zmolnar/sensorio/housing/sensorio.FCStd

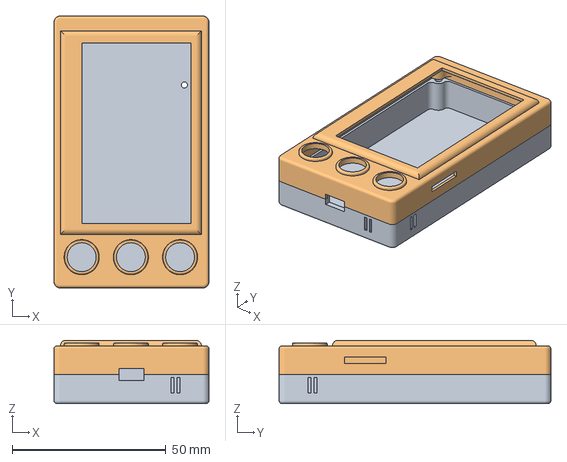
[picture p1: CAD file, 2021-02-22]
housing/sensorio.FCStd
50.4 x 88.4 x 20.6 mm
BackCover
sensorio_v0.4
