zmolnar/sensorio/housing/STL/v0.4/sensorio_v0.4.stl

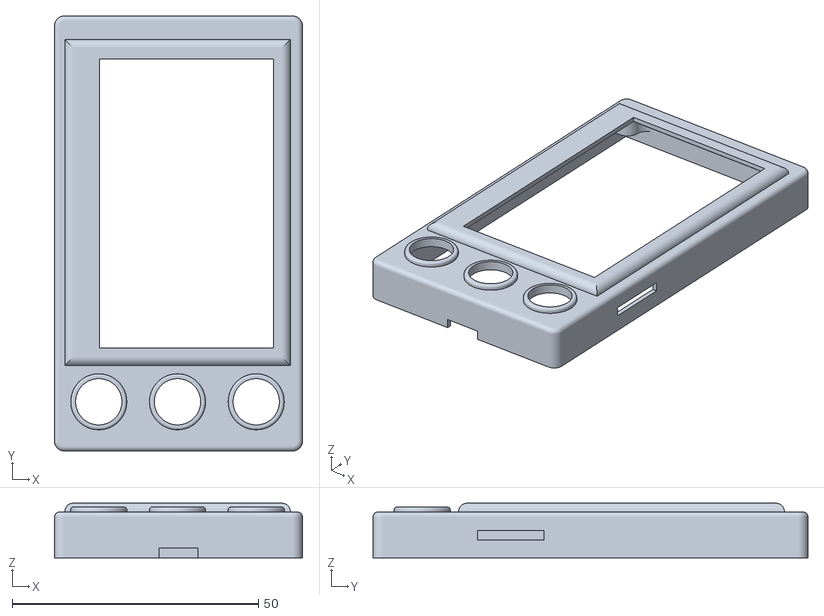
[picture p2: CAD file, 2021-02-16]
housing/STL/v0.4/sensorio_v0.4.stl
50.4 x 88.4 x 11.1
