zmolnar/sensorio/housing/STL/v0.1/button_v01.stl

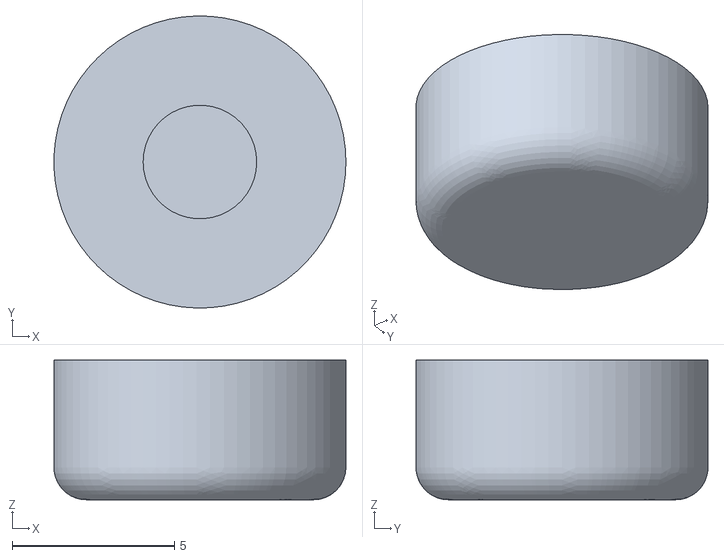
[picture p3: CAD file, 2021-01-31, an earlier design]
housing/STL/v0.1/button_v01.stl
9.00 x 9.00 x 4.30
