zmolnar/sensorio/housing/STL/v0.2/sensorio_v0.2.stl

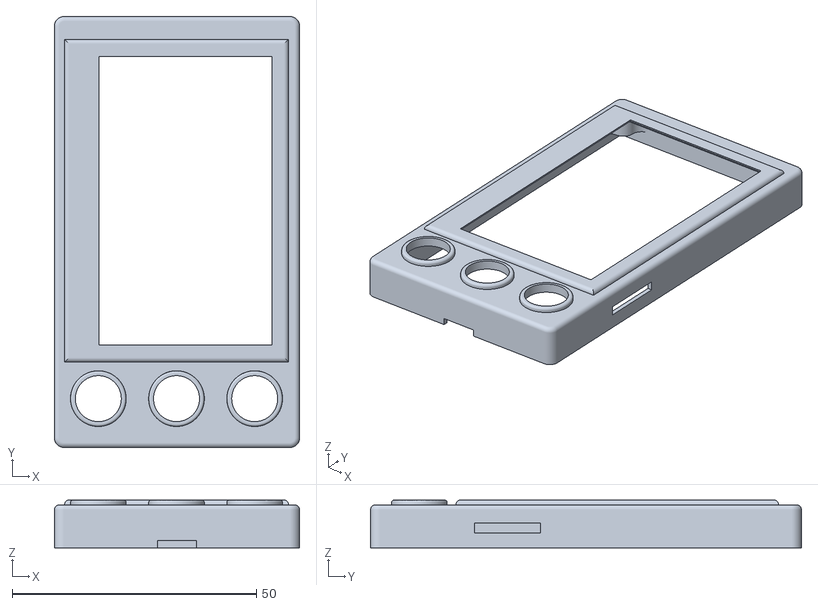
[picture p4: CAD file, 2021-02-11, an earlier design]
housing/STL/v0.2/sensorio_v0.2.stl
50.2 x 88.2 x 9.80
