zmolnar/sensorio/housing/STL/v0.3/sensorio_v0.3.stl

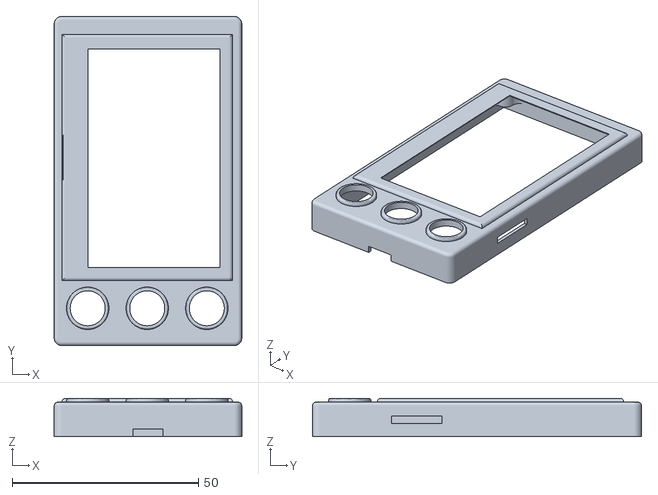
[picture p5: CAD file, 2021-02-11, an earlier design]
housing/STL/v0.3/sensorio_v0.3.stl
50.4 x 88.4 x 10.3
