zmolnar/sensorio/(list of files, cad)

Other CAD files:
housing/STL/v0.3/button_v0.3.stl
