zmolnar/sensorio/hardware/v1/v1.kicad_pcb

## KiCad design hardware/v1/v1.kicad_pcb (2020-12-09)

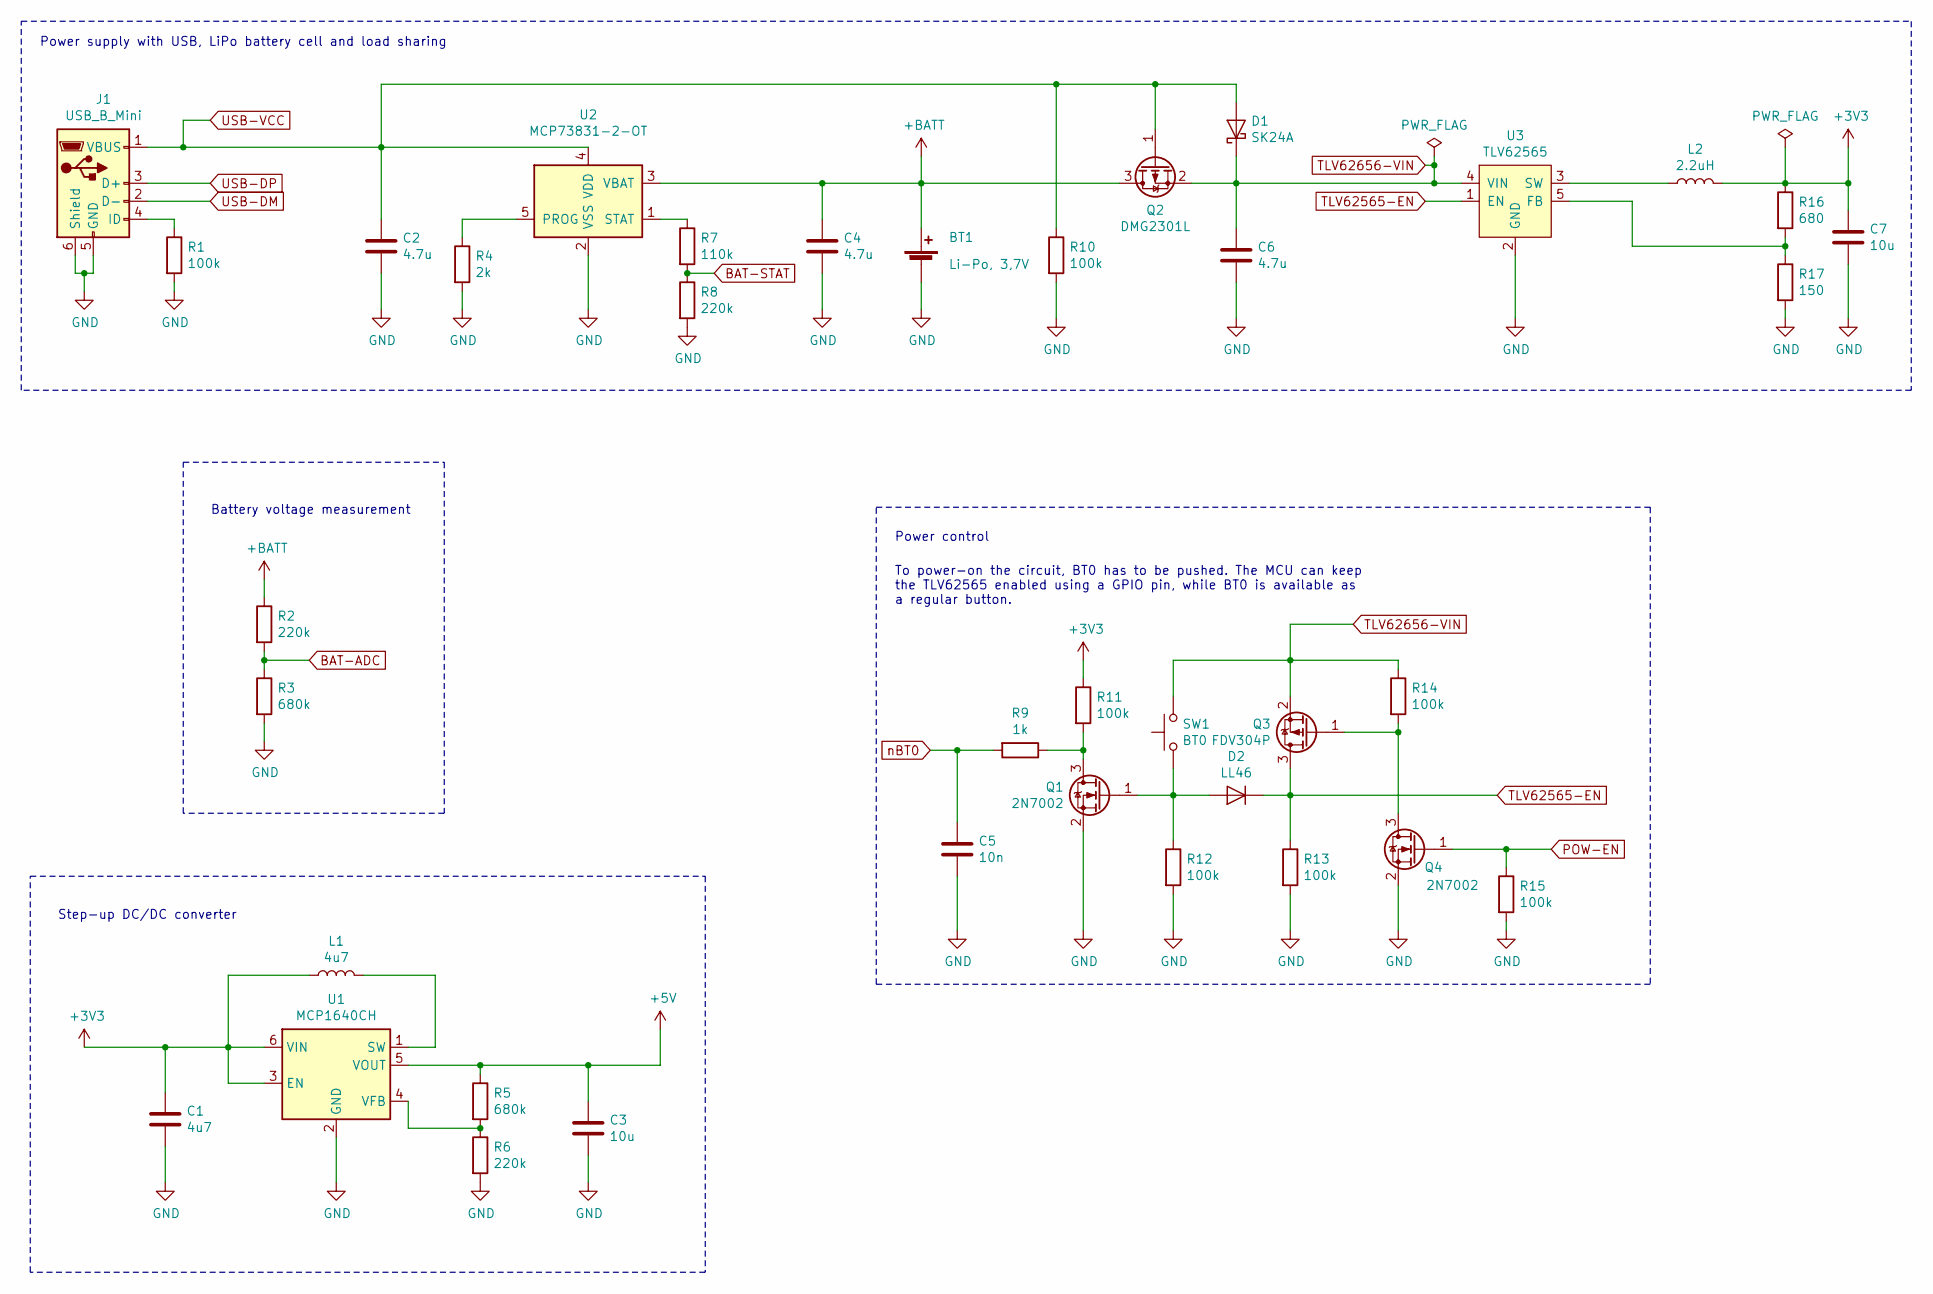
[picture p6: schematic Power.sch]

Parts:
BT1: Li-Po, 3,7V; Battery_103450
C1: 4u7; C_0603_1608Metric_Pad1.05x0.95mm_HandSolder
C2, C4, C6: 4.7u; C_0603_1608Metric_Pad1.05x0.95mm_HandSolder
C3, C7: 10u; C_0603_1608Metric_Pad1.05x0.95mm_HandSolder
C5: 10n; C_0603_1608Metric_Pad1.05x0.95mm_HandSolder
D1: SK24A; D_SMA_Handsoldering
D2: LL46; D_MiniMELF
J1: USB_B_Mini; USB_Mini-B_Lumberg_2486_01_Horizontal
L1: 4u7; Viking_Tech_SDIA0315
L2: 2.2uH; Murata_2u2H_LQH44PN2R2MP0L
Q1, Q4: 2N7002; SOT-23
Q2: DMG2301L; SOT-23; Farnell 3127313
Q3: FDV304P; SOT-23
R1, R10, R11, R12, R13, R14, R15: 100k; R_0603_1608Metric_Pad1.05x0.95mm_HandSolder
R2, R6, R8: 220k; R_0603_1608Metric_Pad1.05x0.95mm_HandSolder
R3, R5: 680k; R_0603_1608Metric_Pad1.05x0.95mm_HandSolder
R4: 2k; R_0603_1608Metric_Pad1.05x0.95mm_HandSolder
R7: 110k; R_0603_1608Metric_Pad1.05x0.95mm_HandSolder
R9: 1k; R_0603_1608Metric_Pad1.05x0.95mm_HandSolder
R16: 680; R_0603_1608Metric_Pad1.05x0.95mm_HandSolder
R17: 150; R_0603_1608Metric_Pad1.05x0.95mm_HandSolder
SW1: BT0; SW_SPST_PTS645
U1: MCP1640CH; SOT-23-6
U2: MCP73831-2-OT; SOT-23-5
U3: TLV62565; SOT-23-5_HandSoldering

Connections:
+3V3: C1.1, C7.1, L1.1, L2.2, R11.1, R16.1, U1.3 (EN), U1.6 (VIN); also elsewhere on the board
+5V: C3.1, R5.1, U1.5 (VOUT); also elsewhere on the board
+BATT: BT1.1 (+), C4.1, Q2.3 (D), R2.1, U2.3 (VBAT)
BAT-ADC: R2.2, R3.1; also elsewhere on the board
BAT-STAT: R7.2, R8.1; also elsewhere on the board
unnamed: D2.2 (A), Q1.1 (G), R12.1, SW1.1
unnamed: J1.4 (ID), R1.1
unnamed: L1.2, U1.1 (SW)
unnamed: L2.1, U3.3 (SW)
unnamed: Q1.3 (D), R9.1, R11.2
unnamed: Q3.1 (G), Q4.3 (D), R14.2
unnamed: R4.1, U2.5 (PROG)
unnamed: R5.2, R6.1, U1.4 (VFB)
unnamed: R7.1, U2.1 (STAT)
unnamed: R16.2, R17.1, U3.5 (FB)
POW-EN: Q4.1 (G), R15.1; also elsewhere on the board
TLV62565-EN: D2.1 (K), Q3.3 (D), R13.1, U3.1 (EN)
TLV62656-VIN: C6.1, D1.1 (K), Q2.2 (S), Q3.2 (S), R14.1, SW1.2, U3.4 (VIN)
USB-DM: J1.2 (D-); also elsewhere on the board
USB-DP: J1.3 (D+); also elsewhere on the board
USB-VCC: C2.1, D1.2 (A), J1.1 (VBUS), Q2.1 (G), R10.1, U2.4 (VDD); also elsewhere on the board
nBT0: C5.1, R9.2; also elsewhere on the board

Notes on the sheet:
To power-on the circuit, BT0 has to be pushed. The MCU can keep the TLV62565 enabled using a GPIO pin, while BT0 is available as a regular button.
Power supply with USB, LiPo battery cell and load sharing
Step-up DC/DC converter
Battery voltage measurement
Power control

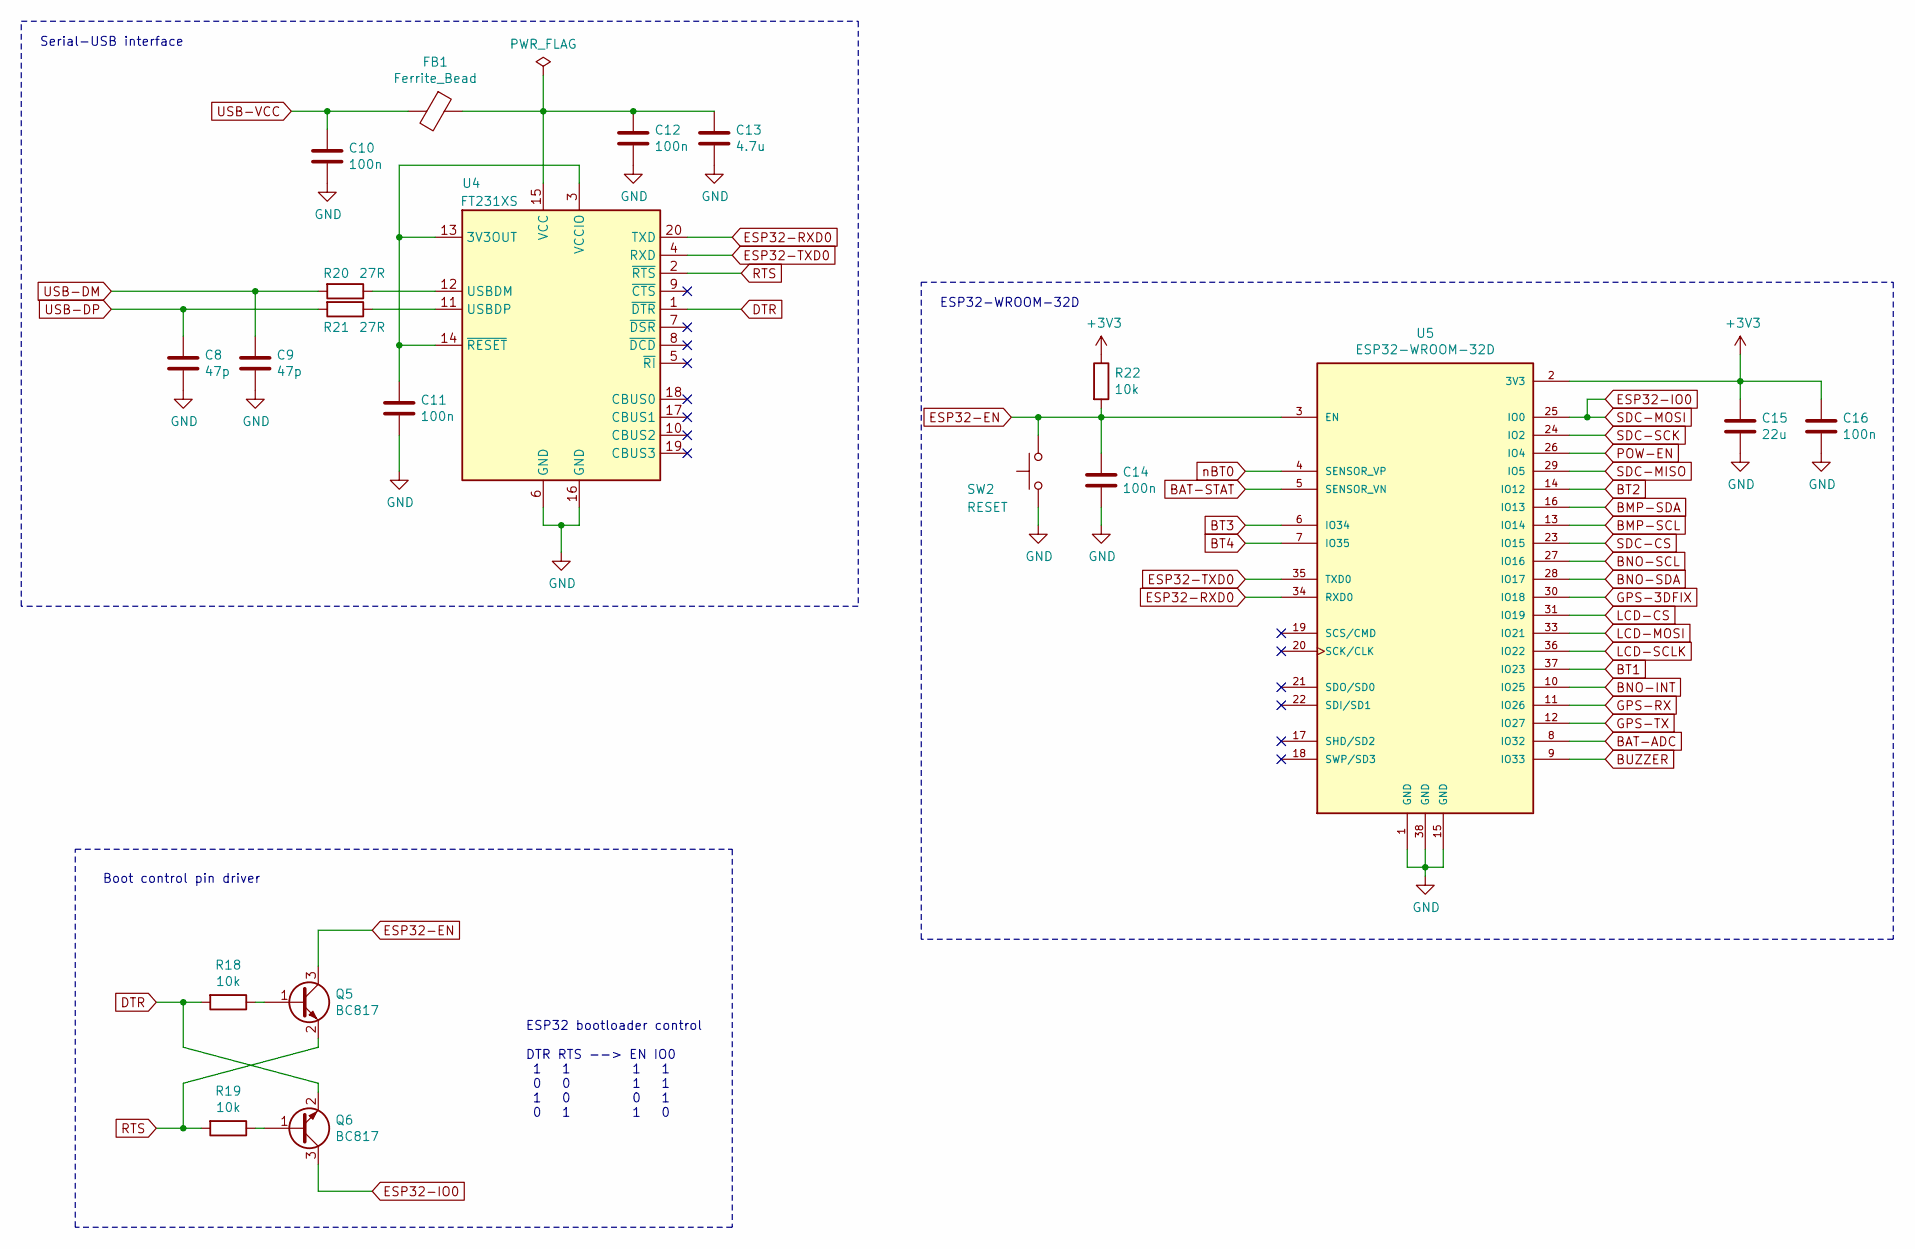
[picture p7: schematic ESP32.sch]

Parts:
C8, C9: 47p; C_0603_1608Metric_Pad1.05x0.95mm_HandSolder
C10, C11, C12, C14, C16: 100n; C_0603_1608Metric_Pad1.05x0.95mm_HandSolder
C13: 4.7u; C_0603_1608Metric_Pad1.05x0.95mm_HandSolder
C15: 22u; C_0603_1608Metric_Pad1.05x0.95mm_HandSolder
FB1: Ferrite_Bead; L_0603_1608Metric_Pad1.05x0.95mm_HandSolder
Q5, Q6: BC817; SOT-23
R18, R19, R22: 10k; R_0603_1608Metric_Pad1.05x0.95mm_HandSolder
R20, R21: 27R; R_0603_1608Metric_Pad1.05x0.95mm_HandSolder
SW2: RESET; SW_SPST_PTS645
U4: FT231XS; SSOP-20_3.9x8.7mm_P0.635mm
U5: ESP32-WROOM-32D; PARTREV 1.9

Connections:
+3V3: C15.1, C16.1, R22.1, U5.2 (3V3); also elsewhere on the board
BAT-ADC: U5.8 (IO32); also elsewhere on the board
BAT-STAT: U5.5 (SENSOR_VN); also elsewhere on the board
BMP-SCL: U5.13 (IO14); also elsewhere on the board
BMP-SDA: U5.16 (IO13); also elsewhere on the board
BNO-INT: U5.10 (IO25); also elsewhere on the board
BNO-SCL: U5.27 (IO16); also elsewhere on the board
BNO-SDA: U5.28 (IO17); also elsewhere on the board
BT1: U5.37 (IO23); also elsewhere on the board
BT2: U5.14 (IO12); also elsewhere on the board
BT3: U5.6 (IO34); also elsewhere on the board
BT4: U5.7 (IO35); also elsewhere on the board
BUZZER: U5.9 (IO33); also elsewhere on the board
DTR: Q6.2 (E), R18.2, U4.1 (~DTR)
ESP32-EN: C14.1, Q5.3 (C), R22.2, SW2.2, U5.3 (EN)
ESP32-IO0: Q6.3 (C), U5.25 (IO0); also elsewhere on the board
ESP32-RXD0: U4.20 (TXD), U5.34 (RXD0)
ESP32-TXD0: U4.4 (RXD), U5.35 (TXD0)
GPS-3DFIX: U5.30 (IO18); also elsewhere on the board
GPS-RX: U5.11 (IO26); also elsewhere on the board
GPS-TX: U5.12 (IO27); also elsewhere on the board
LCD-CS: U5.31 (IO19); also elsewhere on the board
LCD-MOSI: U5.33 (IO21); also elsewhere on the board
LCD-SCLK: U5.36 (IO22); also elsewhere on the board
unnamed: C11.1, U4.3 (VCCIO), U4.13 (3V3OUT), U4.14 (~RESET)
unnamed: C12.1, C13.1, FB1.1, U4.15 (VCC)
unnamed: Q5.1 (B), R18.1
unnamed: Q6.1 (B), R19.1
unnamed: R20.1, U4.12 (USBDM)
unnamed: R21.1, U4.11 (USBDP)
POW-EN: U5.26 (IO4); also elsewhere on the board
RTS: Q5.2 (E), R19.2, U4.2 (~RTS)
SDC-CS: U5.23 (IO15); also elsewhere on the board
SDC-MISO: U5.29 (IO5); also elsewhere on the board
SDC-SCK: U5.24 (IO2); also elsewhere on the board
USB-DM: C9.1, R20.2; also elsewhere on the board
USB-DP: C8.1, R21.2; also elsewhere on the board
USB-VCC: C10.1, FB1.2; also elsewhere on the board
nBT0: U5.4 (SENSOR_VP); also elsewhere on the board

Notes on the sheet:
ESP32 bootloader control DTR RTS --> EN IO0 1 1 1 1 0 0 1 1 1 0 0 1 0 1 1 0
Serial-USB interface
Boot control pin driver
ESP32-WROOM-32D

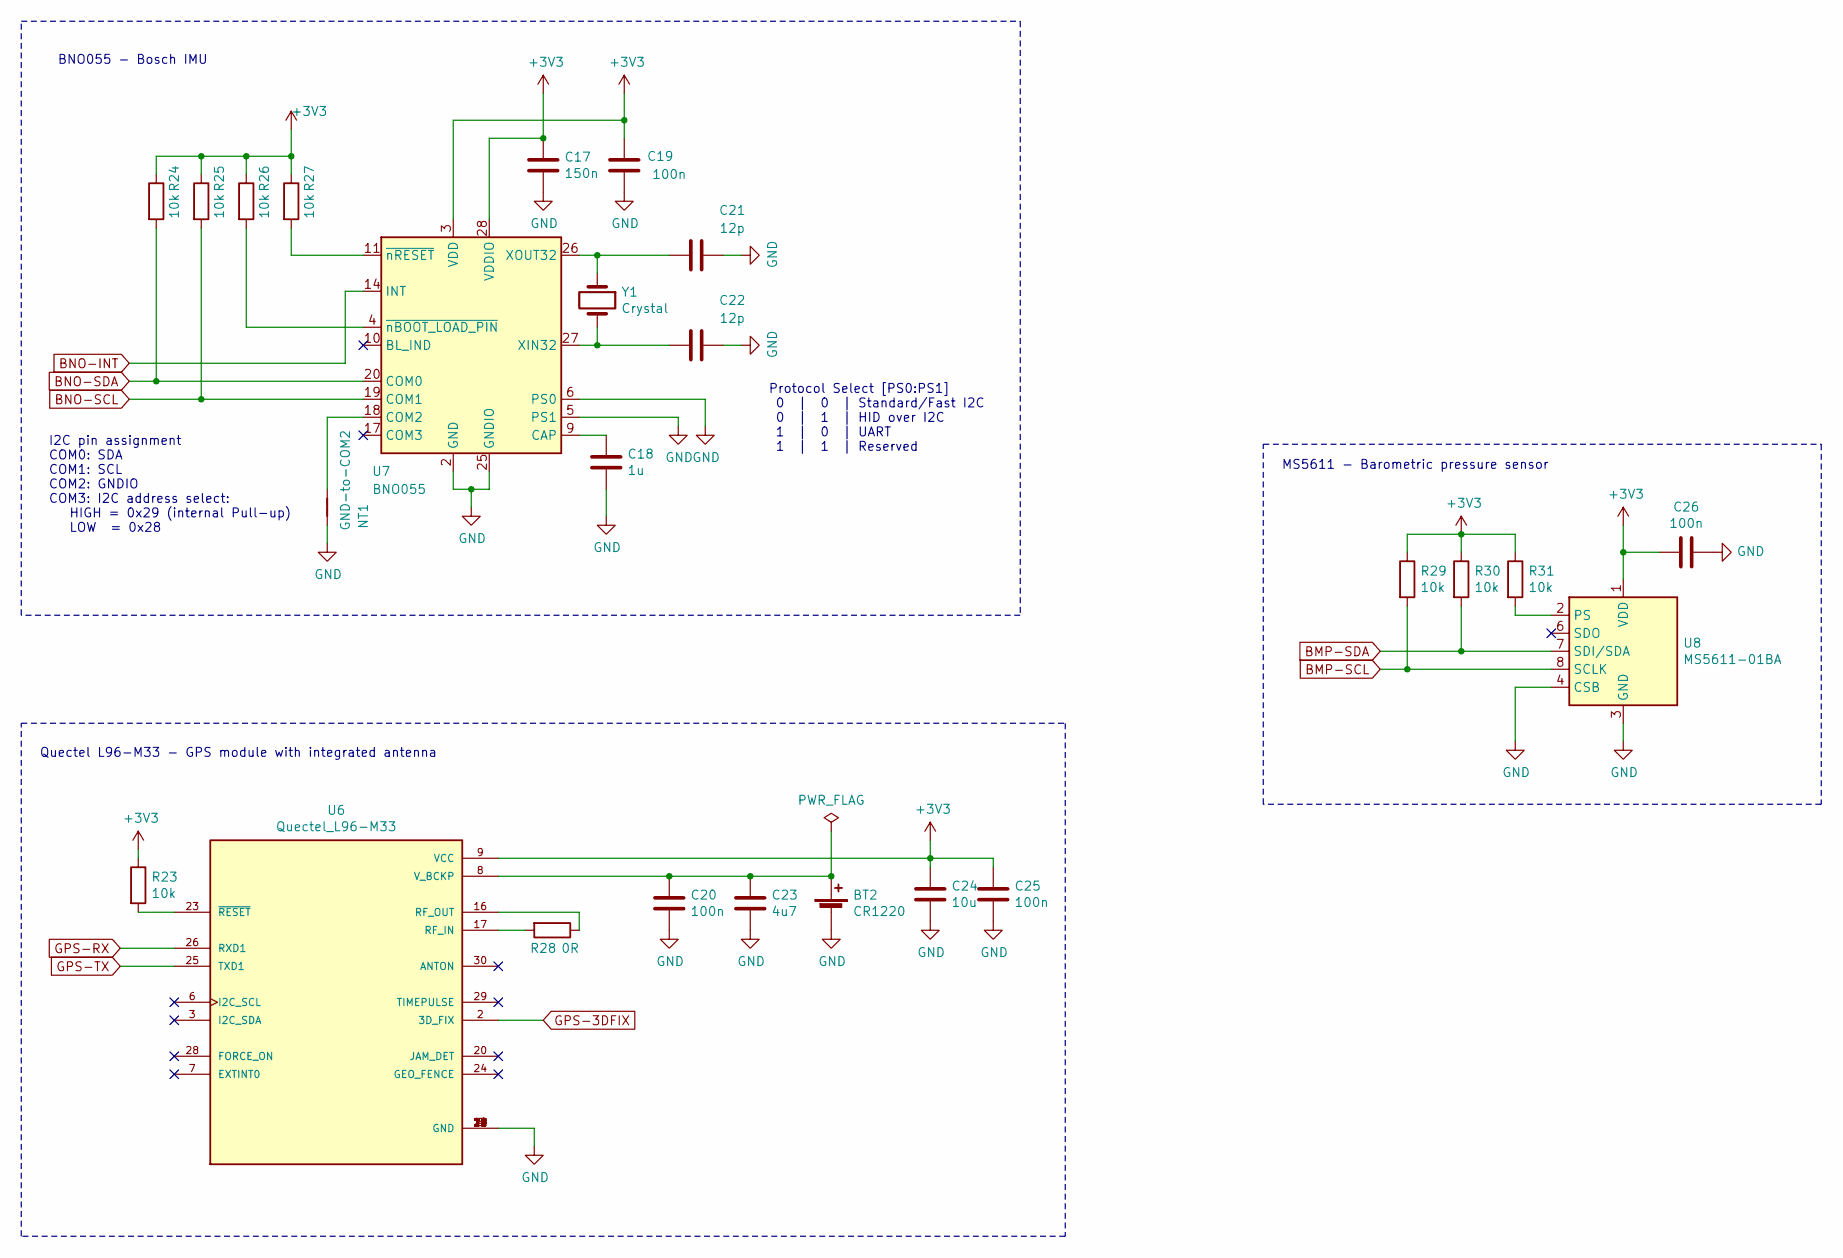
[picture p8: schematic Sensors.sch]

Parts:
BT2: CR1220; BatteryHolder_Keystone_3001_1x12mm; Mouser 534-3001
C17: 150n; C_0603_1608Metric_Pad1.05x0.95mm_HandSolder
C18: 1u; C_0603_1608Metric_Pad1.05x0.95mm_HandSolder
C19, C20, C25, C26: 100n; C_0603_1608Metric_Pad1.05x0.95mm_HandSolder
C21, C22: 12p; C_0603_1608Metric_Pad1.05x0.95mm_HandSolder
C23: 4u7; C_0603_1608Metric_Pad1.05x0.95mm_HandSolder
C24: 10u; C_0603_1608Metric_Pad1.05x0.95mm_HandSolder
NT1: GND-to-COM2; NetTie-2_SMD_Pad0.5mm
R23, R24, R25, R26, R27, R29, R30, R31: 10k; R_0603_1608Metric_Pad1.05x0.95mm_HandSolder
R28: 0R; R_0603_1608Metric_Pad1.05x0.95mm_HandSolder
U6: Quectel_L96-M33
U7: BNO055; LGA-28_5.2x3.8mm_P0.5mm
U8: MS5611-01BA; LGA-8_3x5mm_P1.25mm
Y1: Crystal; Abracon_ABS07-32.768KHZ-T

Connections:
+3V3: C17.2, C19.2, C24.1, C25.1, C26.2, R23.1, R24.1, R25.1, R26.1, R27.1, R29.1, R30.1, R31.1, U6.9 (VCC), U7.3 (VDD), U7.28 (VDDIO), U8.1 (VDD); also elsewhere on the board
BMP-SCL: R29.2, U8.8 (SCLK); also elsewhere on the board
BMP-SDA: R30.2, U8.7 (SDI/SDA); also elsewhere on the board
BNO-INT: U7.14 (INT); also elsewhere on the board
BNO-SCL: R25.2, U7.19 (COM1); also elsewhere on the board
BNO-SDA: R24.2, U7.20 (COM0); also elsewhere on the board
GPS-3DFIX: U6.2 (3D_FIX); also elsewhere on the board
GPS-RX: U6.26 (RXD1); also elsewhere on the board
GPS-TX: U6.25 (TXD1); also elsewhere on the board
unnamed: BT2.1 (+), C20.1, C23.1, U6.8 (V_BCKP)
unnamed: C18.1, U7.9 (CAP)
unnamed: C21.2, U7.26 (XOUT32), Y1.1
unnamed: C22.2, U7.27 (XIN32), Y1.2
unnamed: NT1.1, U7.18 (COM2)
unnamed: R23.2, U6.23 (~RESET)
unnamed: R26.2, U7.4 (~nBOOT_LOAD_PIN)
unnamed: R27.2, U7.11 (~nRESET)
unnamed: R28.1, U6.16 (RF_OUT)
unnamed: R28.2, U6.17 (RF_IN)
unnamed: R31.2, U8.2 (PS)

Notes on the sheet:
I2C pin assignment COM0: SDA COM1: SCL COM2: GNDIO COM3: I2C address select: HIGH = 0x29 (internal Pull-up) LOW = 0x28
Protocol Select [PS0:PS1] 0 | 0 | Standard/Fast I2C 0 | 1 | HID over I2C 1 | 0 | UART 1 | 1 | Reserved
BNO055 - Bosch IMU
MS5611 - Barometric pressure sensor
Quectel L96-M33 - GPS module with integrated antenna

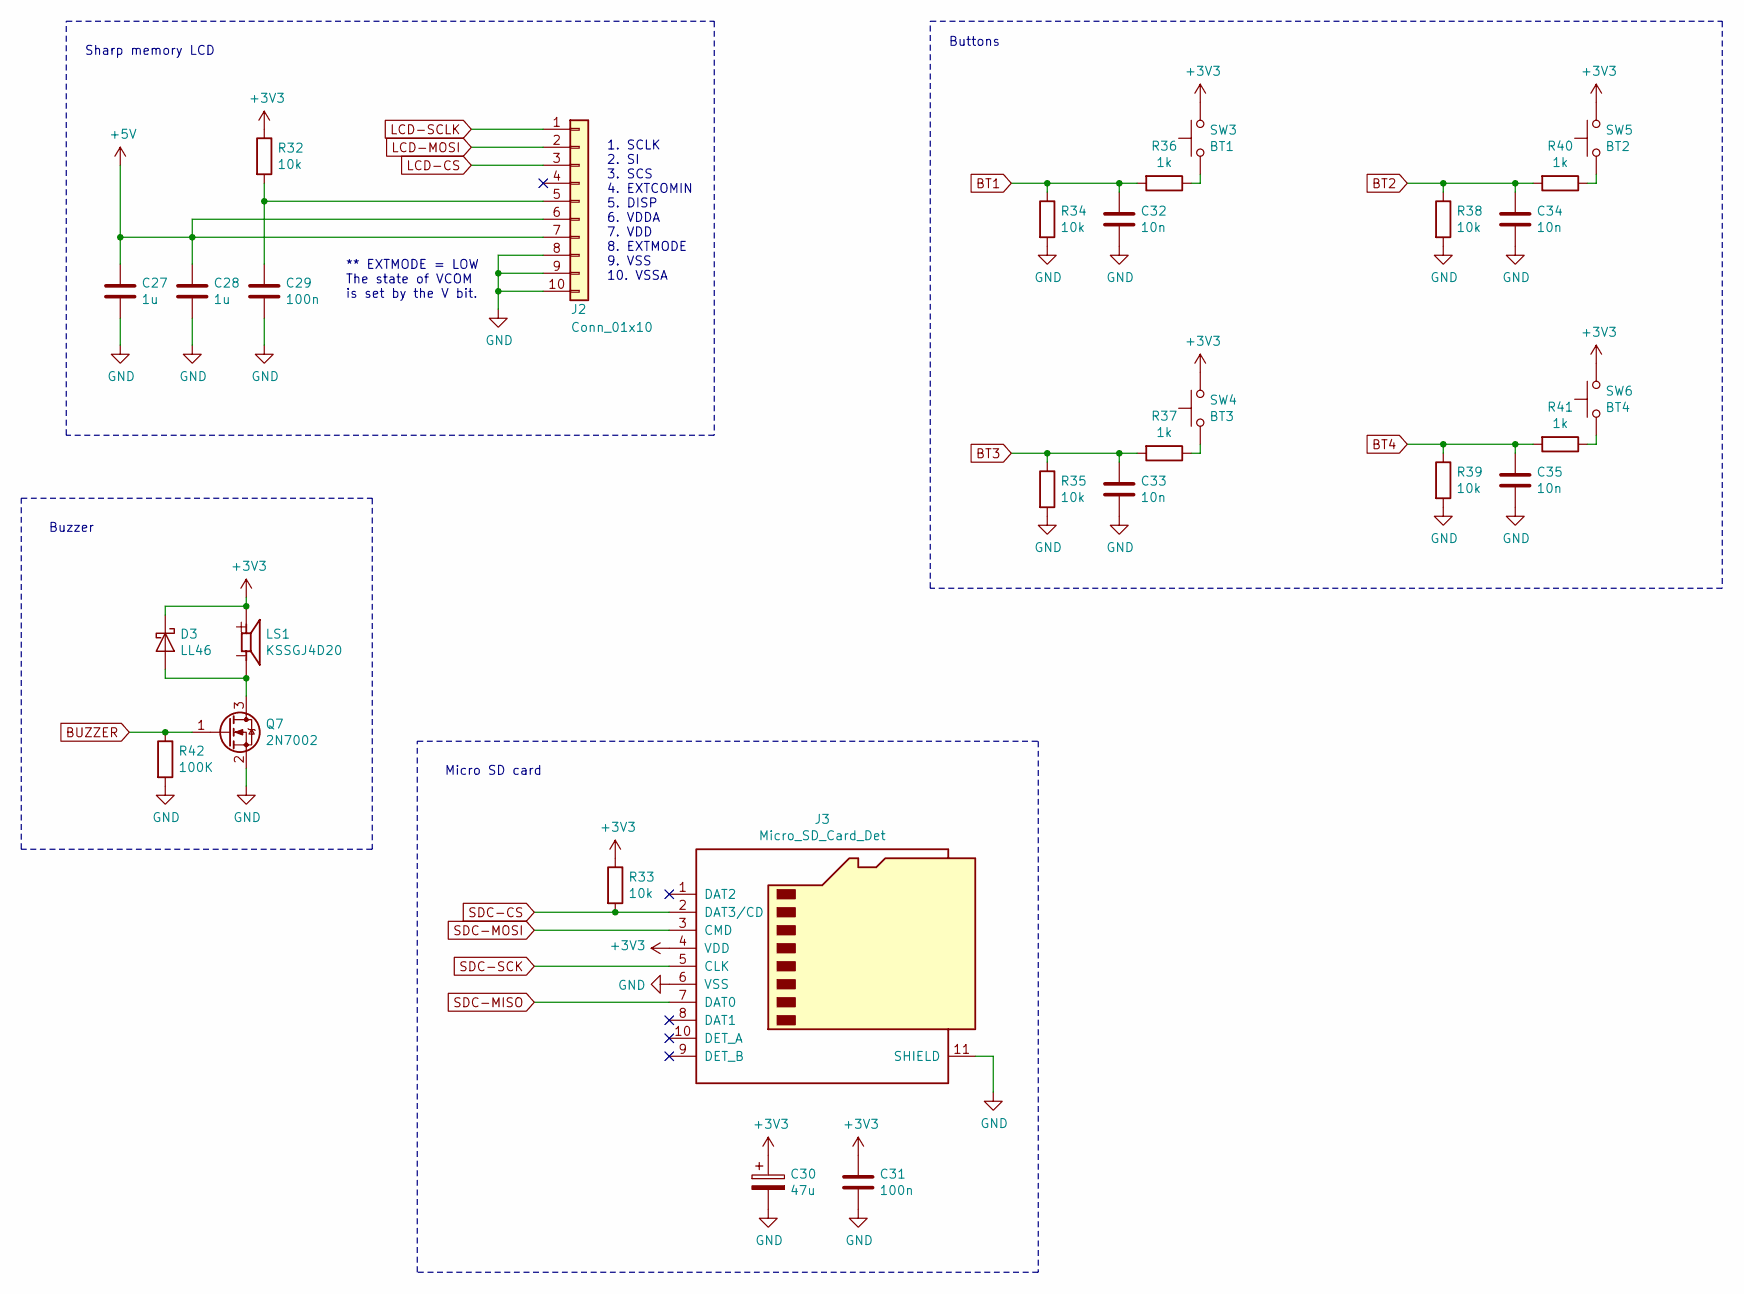
[picture p9: schematic Peripherals.sch]

Parts:
C27, C28: 1u; C_0603_1608Metric_Pad1.05x0.95mm_HandSolder
C29, C31: 100n; C_0603_1608Metric_Pad1.05x0.95mm_HandSolder
C30: 47u; CP_EIA-3528-21_Kemet-B_Pad1.50x2.35mm_HandSolder
C32, C33, C34, C35: 10n; C_0603_1608Metric_Pad1.05x0.95mm_HandSolder
D3: LL46; D_MiniMELF
J2: Conn_01x10; Wuerth_10pin_FPC_68711014022; Farnell top 1641925
J3: Micro_SD_Card_Det; microSD_HC_Hirose_DM3AT-SF-PEJM5
LS1: KSSGJ4D20; PARTREV 1.5
Q7: 2N7002; SOT-23
R32, R33, R34, R35, R38, R39: 10k; R_0603_1608Metric_Pad1.05x0.95mm_HandSolder
R36, R37, R40, R41: 1k; R_0603_1608Metric_Pad1.05x0.95mm_HandSolder
R42: 100K; R_0603_1608Metric_Pad1.05x0.95mm_HandSolder
SW3: BT1; SW_SPST_PTS645
SW4: BT3; Connector_SMD_01x02_2.54
SW5: BT2; SW_SPST_PTS645
SW6: BT4; Connector_SMD_01x02_2.54

Connections:
+3V3: C30.1, C31.1, D3.1 (K), J3.4 (VDD), LS1.P1, LS1.P2, R32.1, R33.1, SW3.2, SW4.2, SW5.2, SW6.2; also elsewhere on the board
+5V: C27.1, C28.1, J2.6, J2.7; also elsewhere on the board
BT1: C32.1, R34.1, R36.2; also elsewhere on the board
BT2: C34.1, R38.1, R40.2; also elsewhere on the board
BT3: C33.1, R35.1, R37.2; also elsewhere on the board
BT4: C35.1, R39.1, R41.2; also elsewhere on the board
BUZZER: Q7.1 (G), R42.1; also elsewhere on the board
ESP32-IO0: J3.3 (CMD); also elsewhere on the board
LCD-CS: J2.3; also elsewhere on the board
LCD-MOSI: J2.2; also elsewhere on the board
LCD-SCLK: J2.1; also elsewhere on the board
unnamed: C29.1, J2.5, R32.2
unnamed: D3.2 (A), LS1.N1, LS1.N2, Q7.3 (D)
unnamed: R36.1, SW3.1
unnamed: R37.1, SW4.1
unnamed: R40.1, SW5.1
unnamed: R41.1, SW6.1
SDC-CS: J3.2 (DAT3/CD), R33.2; also elsewhere on the board
SDC-MISO: J3.7 (DAT0); also elsewhere on the board
SDC-SCK: J3.5 (CLK); also elsewhere on the board

Notes on the sheet:
** EXTMODE = LOW The state of VCOM is set by the V bit.
1. SCLK 2. SI 3. SCS 4. EXTCOMIN 5. DISP 6. VDDA 7. VDD 8. EXTMODE 9. VSS 10. VSSA
Sharp memory LCD
Buzzer
Micro SD card
Buttons

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
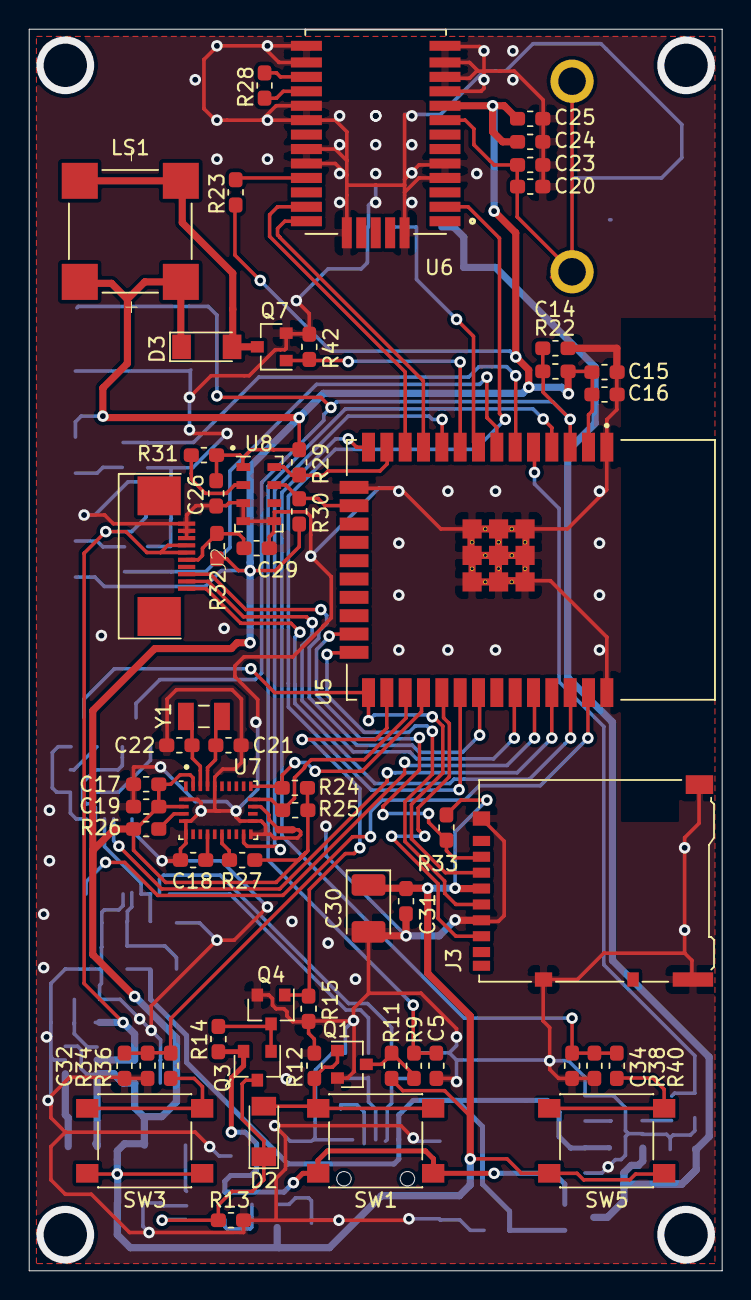
[picture p10: board v1.kicad_pcb from above]

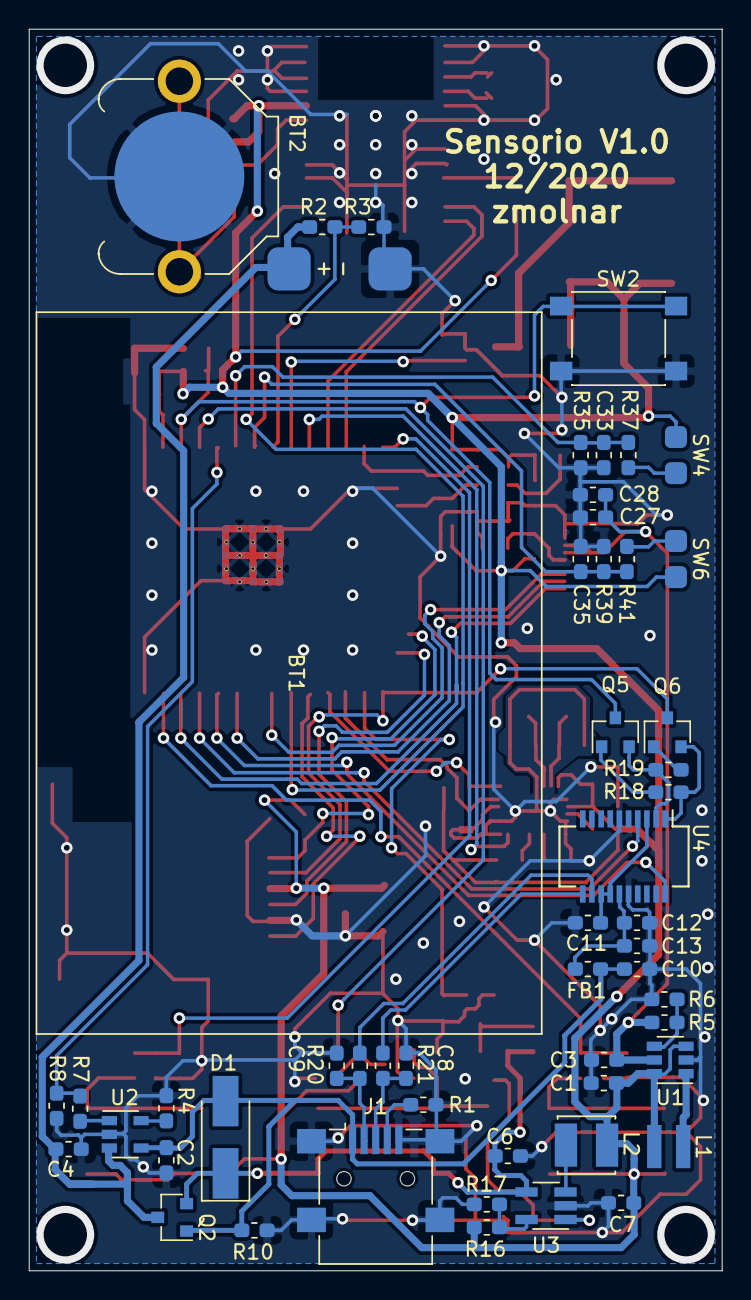
[picture p11: board v1.kicad_pcb from below]

Board: 2 copper layers, 48.0 x 86.0 mm, 112 parts (52 on the bottom side), 71 nets.
