zmolnar/sensorio/firmware/sensorio/src/main.cpp

//
//  This file is part of Sensorio.
//
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

#include <Power.hpp>
#include <core/BatteryMonitorThread.hpp>
#include <core/BeepControlThread.hpp>
#include <core/DataFilterThread.hpp>
#include <core/DataLoggerThread.hpp>
#include <core/GpsManagerThread.hpp>
#include <core/ImuManagerThread.hpp>
#include <core/LvglThread.hpp>
#include <core/PressureReaderThread.hpp>
#include <dashboard/Config.hpp>
#include <dashboard/Dashboard.hpp>
#include <dashboard/NvsStorage.hpp>
#include <dashboard/RawSerializer.hpp>
#include <platform/Log.hpp>

#include <freertos/FreeRTOS.h>
#include <freertos/task.h>

typedef enum {
  PRIO_0_INVALID = 0,
  PRIO_0_BATTMON,
  PRIO_0_LOGGER,
  PRIO_0_BEEPER,
  PRIO_0_GPS,
  PRIO_0_FILTER,
  PRIO_0_IMU,
  PRIO_0_PRESS,
} ThreadPrio_Core0_t;

typedef enum {
  PRIO_1_INVALID = 0,
  PRIO_1_LVGL = 10,
} ThreadPrio_Core1_t;

static const char *tag = "MAIN";

Power Power::obj{};
Dashboard::Dashboard dashboard{};
Config::RawSerializer serializer{};
Config::NvsStorage storage{};
Config::Config config{serializer, storage};

using namespace Platform;

extern "C" void app_main(void) {
  Log::Base::setLevel(Log::Level::DEBUG);
  Log::Info(tag) << "Sensorio started";

  Power::get().start();

  PressureReaderThreadInit();
  ImuManagerThreadInit();
  GpsManagerThreadInit();
  DataFilterThreadInit();
  DataLoggerThreadInit();
  BeepControlThreadInit();
  BatteryMonitorInit();

  storage.init();
  config.load();

#if 1
  xTaskCreatePinnedToCore(
      DataFilterThread, "data filter", 8192, NULL, PRIO_0_FILTER, NULL, 0);
#endif

#if 1
  xTaskCreatePinnedToCore(
      DataLoggerThread, "data logger", 8192, NULL, PRIO_0_LOGGER, NULL, 0);
#endif

#if 1
  xTaskCreatePinnedToCore(PressureReaderThread,
                          "pressure reader",
                          4096,
                          NULL,
                          PRIO_0_PRESS,
                          NULL,
                          0);
#endif

#if 1
  xTaskCreatePinnedToCore(
      BeepControlThread, "beeper", 4096, NULL, PRIO_0_BEEPER, NULL, 0);
#endif

#if 1
  xTaskCreatePinnedToCore(
      ImuManagerThread, "IMU manager", 4096, NULL, PRIO_0_IMU, NULL, 0);
#endif

#if 1
  xTaskCreatePinnedToCore(
      GpsManagerThread, "GPS thread", 4096, NULL, PRIO_0_GPS, NULL, 0);
#endif

#if 1
  xTaskCreatePinnedToCore(BatteryMonitorThread,
                          "Battery thread",
                          2048,
                          NULL,
                          PRIO_0_BATTMON,
                          NULL,
                          0);
#endif

#if 1
  xTaskCreatePinnedToCore(
      LvglThread, "LVGL thread", 16384, NULL, PRIO_1_LVGL, NULL, 1);
#endif

  while (1) {
    vTaskDelay(10000 / portTICK_RATE_MS);
  }
}
