zmolnar/sensorio/firmware/sensorio/src/gui/Sensorio.cpp

/**
 * @file Sensorio.c
 * @brief
 */

/*****************************************************************************/
/* INCLUDES                                                                  */
/*****************************************************************************/
#include "Sensorio.h"
#include "Power.hpp"
#include "core/DataLoggerThread.hpp"
// #include "dashboard/Dashboard.hpp"


#if defined(SIMULATOR)
#include <stdio.h>
#else
#include "core/LvglThread.hpp"
#endif

#include "screens/BpsData.h"
#include "screens/GpsData.h"
#include "screens/ImuData.h"
#include "screens/Startup.h"
#include "screens/SystemStatus.h"
#include "screens/Variometer.h"

/*****************************************************************************/
/* DEFINED CONSTANTS                                                         */
/*****************************************************************************/

/*****************************************************************************/
/* TYPE DEFINITIONS                                                          */
/*****************************************************************************/

/*****************************************************************************/
/* MACRO DEFINITIONS                                                         */
/*****************************************************************************/

/*****************************************************************************/
/* DEFINITION OF GLOBAL CONSTANTS AND VARIABLES                              */
/*****************************************************************************/
#if defined(SIMULATOR)
// Publish it to the global namespace, because app_hal.c needs it.
lv_group_t *encgroup;
#else
static lv_group_t *encgroup;
#endif

// Screen objects
lv_obj_t *startup;
lv_obj_t *vario;
lv_obj_t *bpsdata;
lv_obj_t *imudata;
lv_obj_t *gpsdata;
lv_obj_t *sysstat;

// Default style for the screens
static lv_style_t no_border_style;

// Exit confirmation message box button labels
static const char *exitMsgButtons[] = {"Yes", "Cancel", ""};

/*****************************************************************************/
/* DECLARATION OF LOCAL FUNCTIONS                                            */
/*****************************************************************************/

/*****************************************************************************/
/* DEFINITION OF LOCAL FUNCTIONS                                             */
/*****************************************************************************/
static void group_focus_cb(lv_group_t *g)
{
  lv_obj_t *obj = lv_group_get_focused(g);

  if (vario == obj) {
    lv_scr_load(vario);
  } else if (bpsdata == obj) {
    lv_scr_load(bpsdata);
  } else if (imudata == obj) {
    lv_scr_load(imudata);
  } else if (gpsdata == obj) {
    lv_scr_load(gpsdata);
  } else if (sysstat == obj) {
    lv_scr_load(sysstat);
  } else {
    ;
  }
}

static void exit_msgbox_event_handler(lv_obj_t *obj, lv_event_t event)
{
  if (LV_EVENT_VALUE_CHANGED == event) {
    uint16_t id = lv_msgbox_get_active_btn(obj);

    if (0 == id) {
      lv_obj_clean(lv_scr_act());
      SensorioStop();
    } else {
      SensorioLoadEncoderGroup();
      lv_group_focus_obj(lv_obj_get_parent(obj));
    }

    lv_obj_del(obj);
  }
}

/*****************************************************************************/
/* DEFINITION OF GLOBAL FUNCTIONS                                            */
/*****************************************************************************/
void SensorioStart(void)
{
  lv_style_init(&no_border_style);
  lv_style_set_border_width(&no_border_style, LV_STATE_DEFAULT, 0);

  startup = startup_screen_create(&no_border_style);

#if defined(SIMULATOR)
  // In the simulator app_hal.c will create the group.
#else
  encgroup = lv_group_create();
#endif

  lv_group_set_focus_cb(encgroup, group_focus_cb);

  lv_scr_load(startup);
}

void SensorioStop(void)
{
  LogWaitToFinish();
  Power::get().stop();
}

void SensorioStartupFinished(void)
{
  lv_obj_del(startup);

  vario = variometer_screen_create(&no_border_style);
  bpsdata = bps_data_screen_create(&no_border_style);
  imudata = imu_data_screen_create(&no_border_style);
  gpsdata = gps_data_screen_create(&no_border_style);
  sysstat = system_status_screen_create(&no_border_style);

  SensorioLoadEncoderGroup();
  lv_group_focus_obj(vario);

  Power::get().startupFinished();
}

lv_group_t *SensorioGetEncoderGroup(void)
{
  return encgroup;
}

void SensorioClearEncoderGroup(void)
{
  lv_group_remove_all_objs(encgroup);
  lv_group_set_editing(encgroup, false);
}

void SensorioLoadEncoderGroup(void)
{
  SensorioClearEncoderGroup();
  lv_group_add_obj(encgroup, vario);
  lv_group_add_obj(encgroup, bpsdata);
  lv_group_add_obj(encgroup, imudata);
  lv_group_add_obj(encgroup, gpsdata);
  lv_group_add_obj(encgroup, sysstat);
}

void SensorioConfirmExit(void)
{
  lv_obj_t *mbox = lv_msgbox_create(lv_scr_act(), NULL);
  lv_msgbox_set_text(mbox, "Do you want to exit?");
  lv_msgbox_add_btns(mbox, exitMsgButtons);
  lv_obj_set_width(mbox, 200);
  lv_obj_set_event_cb(mbox, exit_msgbox_event_handler);
  lv_obj_align(mbox, lv_scr_act(), LV_ALIGN_CENTER, 0, 0);

  lv_group_remove_all_objs(encgroup);
  lv_group_add_obj(encgroup, mbox);
}

/****************************** END OF FILE **********************************/
