zmolnar/sensorio/(commit log)

2020-06-02 Copy files from stm32f103-stk EPD prototyping.
2020-07-12 Update board config files and add template for ChibiStudio.
2020-07-17 Create LED blinker and configure SWO pin.
2020-07-18 Add sampler thread ans LPS22HB sensor to the project.
2020-07-19 Add LPS22HB DRDY interrupt handling.
2020-07-19 Remove ChibiOS submodule and add its content as source files.
    [STM32L4+.ods, stm_spc56ec74a256s_spc56ec74_minimodule_debug_jtag.cfg, stm_xpc560b64_minimodule_debug_jtag.cfg, stm_xpc560b_spc560d40_minimodule_debug_jtag.cfg, stm_xpc560p_minimodule_40mhz_debug_jtag.cfg, stm_xpc563m64_minimodule_debug_jtag.cfg, stm_xpc564a_spc564a70_minimodule_debug_jtag.cfg, stm_xpc56el_minimodule_lockstep_debug_jtag.cfg]
2020-09-19 Add SWO printout to debug data.
2020-10-14 Make UART work to transmit data. Setup LSM6DSL sensor.
2020-12-06 Board V1.0 all nets connected.
    [ESP32.sch, Peripherals.sch, Power.sch, Proto.sch, Sensors.sch, v1.kicad_pcb, v1.sch]
2020-12-06 Tracks sorted out, without ground plane.
    [v1.kicad_pcb]
2020-12-07 V1.0 RC1
    [v1.kicad_pcb]
2020-12-08 V1.0 RC2
    [v1.csv, v1.kicad_pcb, v1_bom.xlsx]
2020-12-09 V1.0 RC3
    [v1.kicad_pcb, v1_bom.xlsx]
2020-12-09 V1.0 final revision
    [v1-B_Cu.gbl, v1-B_Mask.gbs, v1-B_SilkS.gbo, v1-F_Cu.gtl, v1-F_Mask.gts, v1-F_SilkS.gto, v1-NPTH.drl, v1-PTH.drl]
2020-12-24 Remove all files from firmware folder.
    [STM32L4+.ods, stm_spc56ec74a256s_spc56ec74_minimodule_debug_jtag.cfg, stm_xpc560b64_minimodule_debug_jtag.cfg, stm_xpc560b_spc560d40_minimodule_debug_jtag.cfg, stm_xpc560p_minimodule_40mhz_debug_jtag.cfg, stm_xpc563m64_minimodule_debug_jtag.cfg, stm_xpc564a_spc564a70_minimodule_debug_jtag.cfg, stm_xpc56el_minimodule_lockstep_debug_jtag.cfg]
2020-12-25 Add MS5611 driver base with reset and PROM validation.
    [PressureReaderThread.cpp, main.cpp]
2020-12-26 Add temp and pressure conversion methods to the MS5611 driver.
2020-12-26 Add official Bosch driver for the BNO055 IMU.
2020-12-27 Add cpp wrapper for the BST driver, and the IMU manager thread.
2020-12-27 Update MS5611 driver and thread.
2020-12-28 Add interrupt config support to the BNO055 driver.
2020-12-31 Add LVGL and Sharp memory LCD driver.
2020-12-31 Implement Encoder driver for LVGL.
2021-01-01 Add GPS manager thread.
2021-01-12 Make GPS manager thread work with real sensor.
2021-01-12 Write GPIO pin HIGH to keep the power enabled after startup.
2021-01-12 Connect PressureReaderThread to the dashboard.
2021-01-14 Clean up IMU manager thread. Synchronization is still not fully implemented.
2021-01-14 Implement data sampling timer and task synchronization.
2021-01-14 Connect IMU manager thread to the dashboard.
2021-01-16 Make sharp memory LCD driver work with real hardware.
2021-01-17 Make the encoder driver work with real hardware.
2021-01-19 Add encoder to the simulator and implement exit confirmation before shutting down.
2021-01-20 Fix mutual exclusion issue in handling of the shutdown request.
    [Encoder.cpp, LvglThread.cpp]
2021-01-20 Add Pressure Sensor screen to the gui.
2021-01-21 Add IMU data screen.
2021-01-22 Add Battery monitor thread to monitor the battery level.
2021-01-22 Implement charge status detection, although the voltage devider needs to be replaced with higher value resistors to make it work.
    [BatteryMonitorThread.cpp]
2021-01-23 Add filter output to the dashboard.
2021-01-24 Update IMU data screen layout.
2021-01-27 Add housing to the project.
    [sensorio.FCStd]
2021-01-27 Add cut for display cable to the housing front cover.
    [sensorio.FCStd]
2021-01-28 Add openings for the buttons.
    [sensorio.FCStd]
2021-01-28 Add screw holes and pads.
    [sensorio.FCStd]
2021-01-30 Update bolt mounting.
    [sensorio.FCStd]
2021-01-30 Add button.
    [sensorio.FCStd]
2021-01-31 Add SD card and USB slots, and fix sizing.
    [sensorio.FCStd]
2021-01-31 Add fillets to the front cover.
    [sensorio.FCStd]
2021-01-31 Generate v0.1 meshes.
    [button_v01.stl]
2021-02-11 Update dimensions to reflect printer tolerance.
    [sensorio.FCStd]
2021-02-11 Add v0.2 meshes.
    [sensorio_v0.2.stl]
2021-02-11 Update dimensions to 0.4mm tolerance.
    [sensorio.FCStd]
2021-02-11 Add air intake.
    [sensorio.FCStd]
2021-02-11 Add v0.3 meshes.
    [button_v0.3.stl, sensorio_v0.3.stl]
2021-02-12 Fix encoder group manipulation when exit is cancelled.
    [Sensorio.c]
2021-02-15 Increase display frame thickness.
    [sensorio.FCStd]
2021-02-15 Add v0.4 meshes.
    [sensorio_v0.4.stl]
2021-02-18 Implement vario settings screen and fix config handling.
    [Encoder.cpp, Sensorio.c, main.c]
2021-02-22 Create back cover.
    [sensorio.FCStd]
2021-03-09 Implement data filter thread and add python model for the Kalman filter.
2021-03-30 Cut out unscented transformatioin and create a new function.
2021-03-31 Add calibration status to the IMU screen.
2021-03-31 Add UKF to the data filter thread.
2021-04-03 Run the filter with different parameters to compare the results.
2021-04-11 Fix GPS data display.
    [GpsManagerThread.cpp]
2021-04-12 Add IMU calibration to the dashboard. Refactor needed.
2021-04-15 Implement IMU calibration.
2021-04-16 Add filter parameters structure to the dashboard.
2021-04-20 Add thread for logging data.
2021-04-24 Use semaphore instead of notification to sync data filtering thread.
2021-04-24 Use binary semaphore to sync IMU manager thread.
2021-04-29 Add beep control thread.
2021-04-29 Modify sensor init sequence for IMU and BPS.
2021-05-07 Fix dt in sd card logging.
    [DataFilterThread.cpp]
2021-05-10 Refactor IMU manager thread.
2021-05-10 Invert error logic in IMU manager. (Functions return true in case of error and false upon success.)
    [ImuManagerThread.cpp]
2021-05-17 Remove Arduino from the encoder, lcd and lvgl thread.
2021-05-19 Make I2C and MS5611 work.
2021-05-22 Rebase BNO055 and Imu manager thread to use ESP IDF.
2021-05-23 Add data filter thread.
2021-05-29 Add battery monitor.
2021-05-31 Minor renaming and fixes.
    [BatteryMonitorThread.cpp, BeepControlThread.cpp, DataFilterThread.cpp, DataLoggerThread.cpp, Encoder.cpp, GpsManagerThread.cpp, ImuManagerThread.cpp]
2021-06-01 Fix the scheduling of sensor data sampling.
    [DataFilterThread.cpp, DataLoggerThread.cpp, ImuManagerThread.cpp, PressureReaderThread.cpp]
2021-06-05 Add local time handling and fix minor bugs.
    [Sensorio.c]
2021-08-28 Fix GPS comm issue and prevent event storm.
    [GpsManagerThread.cpp]
2021-11-18 Rework Dashboard and Config modules.
    [BatteryMonitorThread.cpp, BeepControlThread.cpp]
2021-11-27 Rewrite kalman filtering using templates
2021-12-10 Rewrite Power module.
2021-12-10 Refactor battery monitor thread.
2021-12-10 Refactor data filter thread.
2021-12-10 Refactor data logger thread.
2021-12-10 Refactor GPS manager thread.
2021-12-12 Refactor pressure reader thread.
2022-02-12 Refactor beep control thread.
2022-02-12 Refactor LVGL thread
2022-02-12 Refactor encoder driver
2022-02-12 Refacto LCD driver
2022-02-12 Refactor MS5611 driver
